rallekralle11/dis_thermometer/README.md

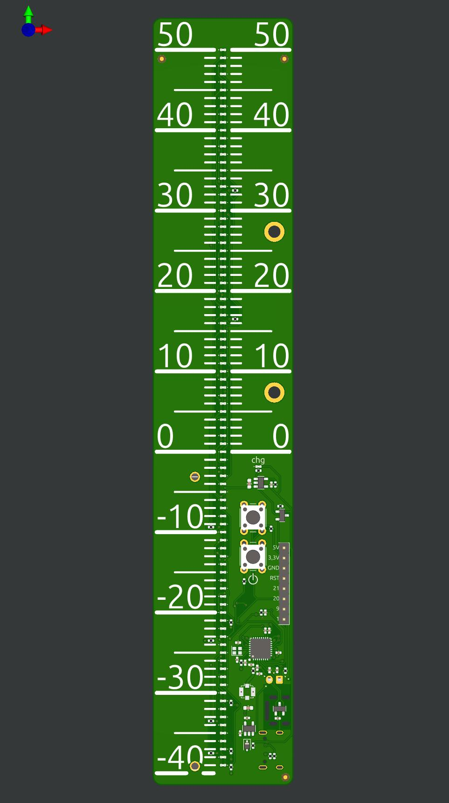
[picture p1: termometer_h.jpg]

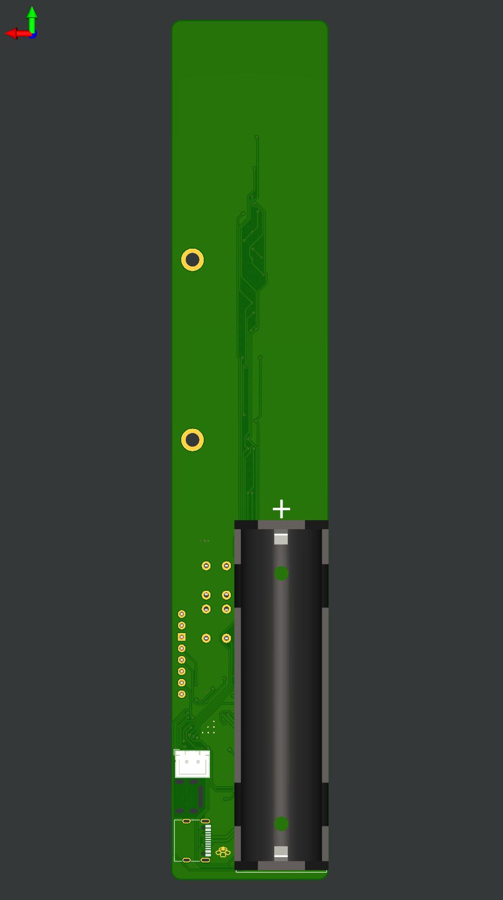
[picture p2: termometer_b.jpg]
