rallekralle11/dis_thermometer/V2_0603/safety.odt

Epi 32U4

safety information

Retain this document

for future reference

Safe use:

- The device should not be operated at above 5,5V DC
- Do not place the powered device on a conductive surface
- Do not expose the device to water
- Do not operate the device at temperatures above 85°C or below -40°C
- Handle the device carefully to prevent mechanical damage and electrostatic discharge
- Double-check the battery polarity before connecting

Warning

Small parts. Do not let

young children access

the device, accessories

or packaging.

Do not dispose of the device

as household waste.

Epi 32U4

säkerhets-information

Spara detta dokument

för framtida referens

Säker användning:

- Produkten bör inte ges över 5,5V DC
- Placera ej den påslagna produkten på ledande ytor
- Håll produkten borta från vatten
- Använd inte produkten I temperaturer över 85°C eller under -40°C
- Hantera produkten varsamt för att undvika mekaniska skador samt statisk urladdning
- Dubbelkolla batteriets polaritet innan det kopplas in

Varning

Små delar. Låt inte mindre barn nå produkten, tillbehören eller förpackningen.

Släng ej produkten

I hushållssopor.

Epi 32U4

Sicherheits-information

Bewahren sie dieses Dokument zum späteren Nachschlagen auf.

Sicherheitshinweise:

- Das Gerät sollte nicht mit mehr als 5,5V DC betrieben werden
- Platzieren Sie das mit Strom versorgte Gerät nicht auf einer leitfähigen Oberfläche
- Setzen Sie das Gerät keinem Wasser aus
- Betreiben Sie das Gerät nicht bei Temperaturen über 85°C oder unter -40°C
- Behandeln Sie das Gerät sorgfältig, verhindern sie mechanische Beschädigungen und elektrostatische Entladung
- Überprüfen Sie noch einmal die Polarität bevor Sie die Batterie anschließen

Warnung

Verschluckbare Kleinteile. Bewahren sie das Gerät, Zubehör und die Verpackung außer Reichweite von Kleinkindern auf.

Entsorgen Sie das Gerät nicht über den Hausmüll.

Epi 32U4

säkerhets-information

Spara detta dokument

för framtida referens

Säker användning:

- Produkten bör inte ges över 5,5V DC
- Placera ej den påslagna produkten på ledande ytor
- Håll produkten borta från vatten
- Använd inte produkten I temperaturer över 85°C eller under -40°C
- Hantera produkten varsamt för att undvika mekaniska skador samt statisk urladdning
- Dubbelkolla batteriets polaritet innan det kopplas in

Varning

Små delar. Låt inte mindre barn nå produkten, tillbehören eller förpackningen.

Släng ej produkten

I hushållssopor.

Epi 32U4

safety information

Retain this document

for future reference

Safe use:

- The device should not be operated at above 5,5V DC
- Do not place the powered device on a conductive surface
- Do not expose the device to water
- Do not operate the device at temperatures above 85°C or below -40°C
- Handle the device carefully to prevent mechanical damage and electrostatic discharge
- Double-check the battery polarity before connecting

Warning

Small parts. Do not let

young children access

the device, accessories

or packaging.

Do not dispose of the device

as household waste.

Epi 32U4

Sicherheits-information

Bewahren sie dieses Dokument zum späteren Nachschlagen auf.

Sicherheitshinweise:

- Das Gerät sollte nicht mit mehr als 5,5V DC betrieben werden
- Platzieren Sie das mit Strom versorgte Gerät nicht auf einer leitfähigen Oberfläche
- Setzen Sie das Gerät keinem Wasser aus
- Betreiben Sie das Gerät nicht bei Temperaturen über 85°C oder unter -40°C
- Behandeln Sie das Gerät sorgfältig, verhindern sie mechanische Beschädigungen und elektrostatische Entladung
- Überprüfen Sie noch einmal die Polarität bevor Sie die Batterie anschließen

Warnung

Verschluckbare Kleinteile. Bewahren sie das Gerät, Zubehör und die Verpackung außer Reichweite von Kleinkindern auf.

Entsorgen Sie das Gerät nicht über den Hausmüll.

Epi 32U4

säkerhets-information

Spara detta dokument

för framtida referens

Säker användning:

- Produkten bör inte ges över 5,5V DC
- Placera ej den påslagna produkten på ledande ytor
- Håll produkten borta från vatten
- Använd inte produkten I temperaturer över 85°C eller under -40°C
- Hantera produkten varsamt för att undvika mekaniska skador samt statisk urladdning
- Dubbelkolla batteriets polaritet innan det kopplas in

Varning

Små delar. Låt inte mindre barn nå produkten, tillbehören eller förpackningen.

Släng ej produkten

I hushållssopor.

Epi 32U4

safety information

Retain this document

for future reference

Safe use:

- The device should not be operated at above 5,5V DC
- Do not place the powered device on a conductive surface
- Do not expose the device to water
- Do not operate the device at temperatures above 85°C or below -40°C
- Handle the device carefully to prevent mechanical damage and electrostatic discharge
- Double-check the battery polarity before connecting

Warning

Small parts. Do not let

young children access

the device, accessories

or packaging.

Do not dispose of the device

as household waste.

Epi 32U4

safety information

Retain this document

for future reference

Safe use:

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

Warning

Small parts. Do not let

young children access

the device, accessories

or packaging.

Do not dispose of the device

as household waste.

Epi 32U4

Sicherheits-information

Bewahren sie dieses Dokument zum späteren Nachschlagen auf.

Sicherheitshinweise:

- Das Gerät sollte nicht mit mehr als 5,5V DC betrieben werden
- Platzieren Sie das mit Strom versorgte Gerät nicht auf einer leitfähigen Oberfläche
- Setzen Sie das Gerät keinem Wasser aus
- Betreiben Sie das Gerät nicht bei Temperaturen über 85°C oder unter -40°C
- Behandeln Sie das Gerät sorgfältig, verhindern sie mechanische Beschädigungen und elektrostatische Entladung
- Überprüfen Sie noch einmal die Polarität bevor Sie die Batterie anschließen

Warnung

Verschluckbare Kleinteile. Bewahren sie das Gerät, Zubehör und die Verpackung außer Reichweite von Kleinkindern auf.

Entsorgen Sie das Gerät nicht über den Hausmüll.

Epi 32U4

Sicherheits-information

Bewahren sie dieses Dokument zum späteren Nachschlagen auf.

Sicherheitshinweise:

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

Warnung

Verschluckbare Kleinteile. Bewahren sie das Gerät, Zubehör und die Verpackung außer Reichweite von Kleinkindern auf.

Entsorgen Sie das Gerät nicht über den Hausmüll.

Epi 32U4

säkerhets-information

Spara detta dokument

för framtida referens

Säker användning:

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

Varning

Små delar. Låt inte mindre barn nå produkten, tillbehören eller förpackningen.

Släng ej produkten

I hushållssopor.
