rallekralle11/dis_thermometer/V2_0603/termometer2.jpg

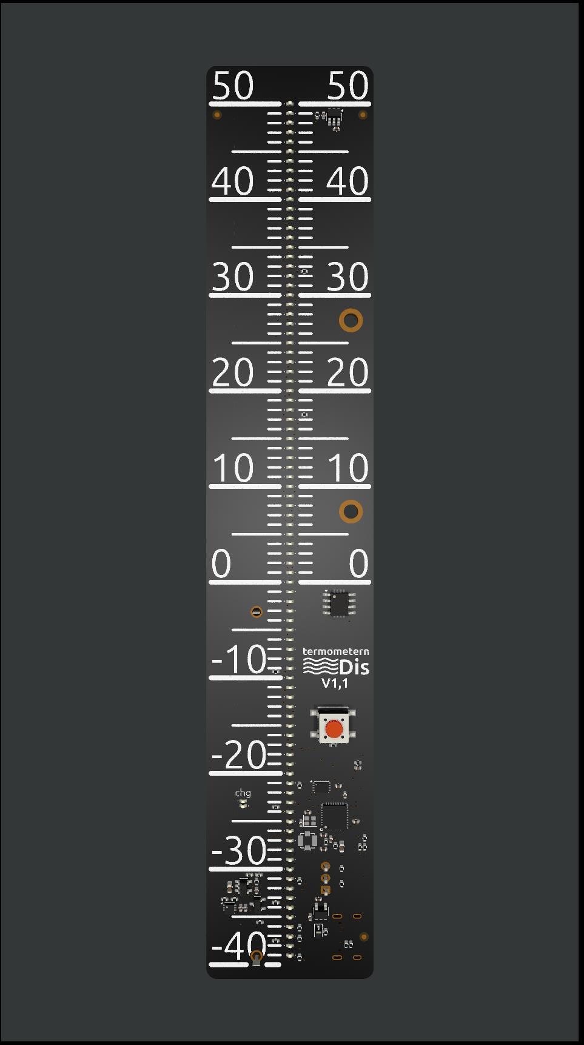
V2_0603/termometer2.jpg
