rallekralle11/dis_thermometer/dis_hållare_lumen.FCStd

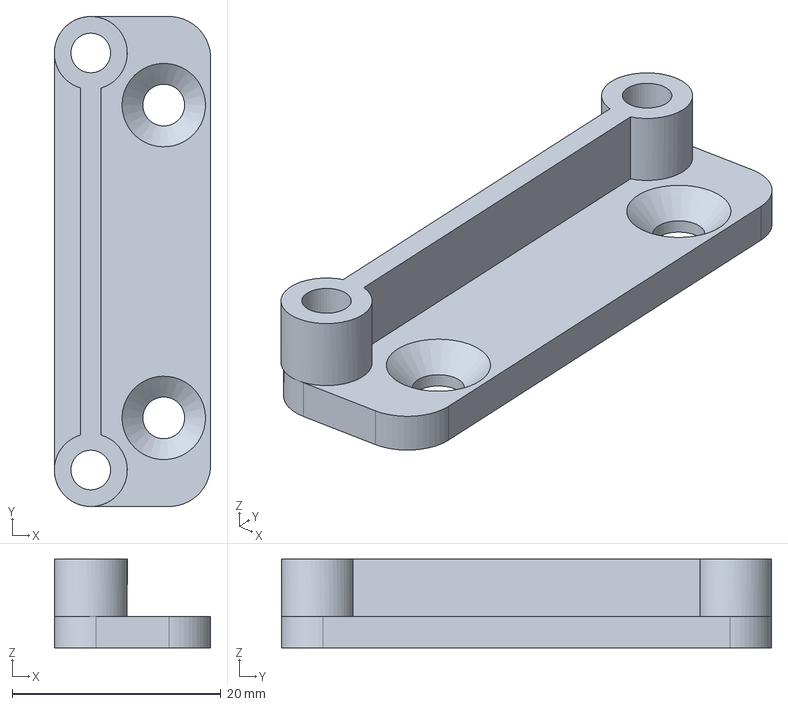
[picture p4: CAD file, 2024-12-08]
dis_hållare_lumen.FCStd
15.0 x 47.0 x 8.50 mm
