rallekralle11/dis_thermometer/V2_0603/jst_gjutform-Body001.obj

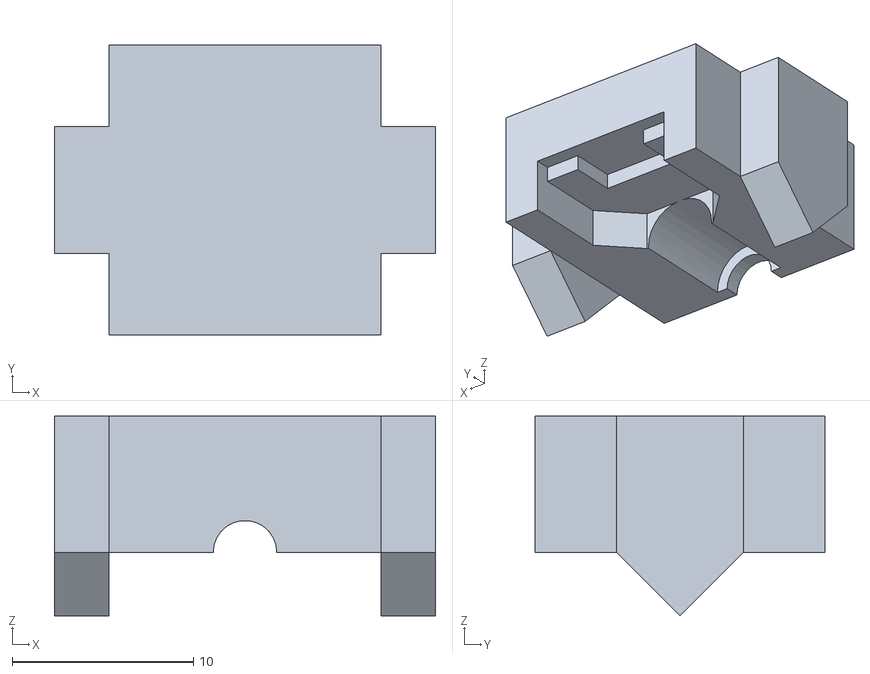
[picture p5: CAD file, 2025-01-25]
V2_0603/jst_gjutform-Body001.obj
21.0 x 16.0 x 11.0
