rallekralle11/dis_thermometer/dis_vägghållare-Body.obj

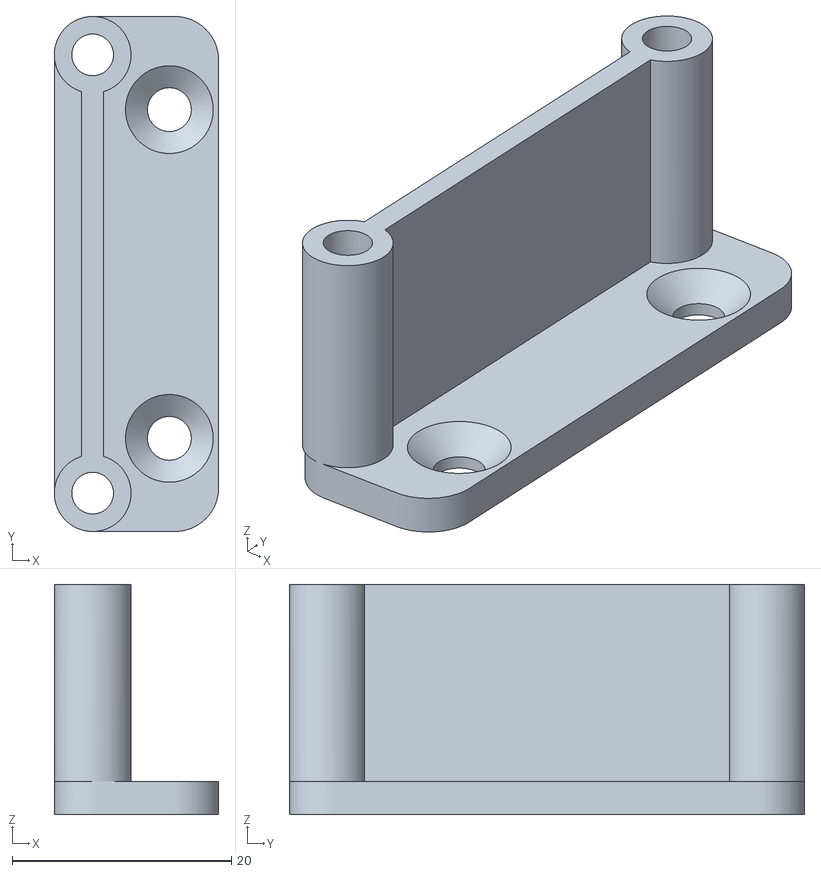
[picture p6: CAD file, 2024-12-08]
dis_vägghållare-Body.obj
15.0 x 47.0 x 21.0
