rallekralle11/dis_thermometer/V2_0603/jst_gjutform-Body.obj

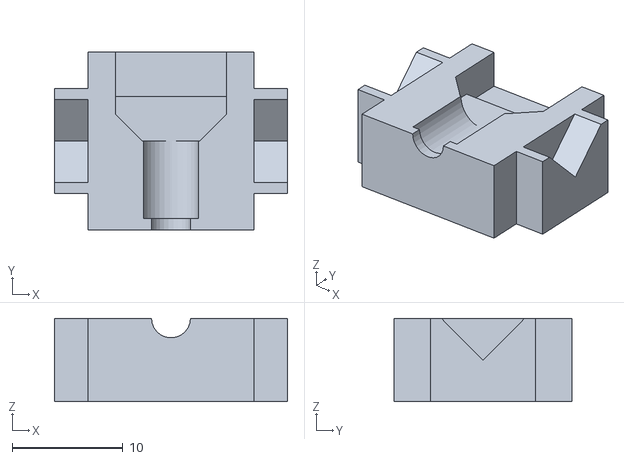
[picture p7: CAD file, 2025-01-25]
V2_0603/jst_gjutform-Body.obj
21.0 x 16.0 x 7.50
