rallekralle11/dis_thermometer/dis_hållare_lumen-Body.obj

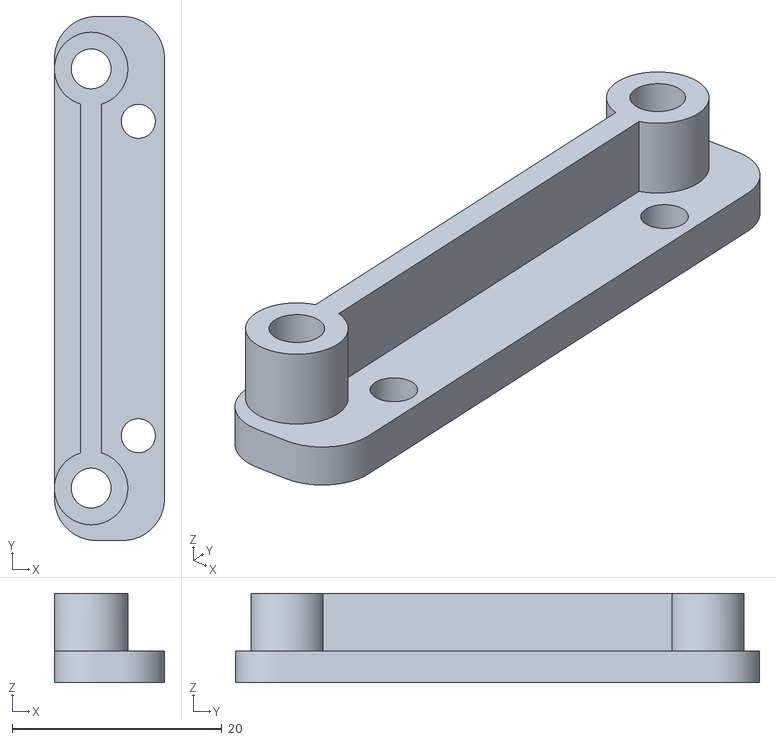
[picture p8: CAD file, 2024-12-06]
dis_hållare_lumen-Body.obj
10.5 x 50.0 x 8.50
