rallekralle11/dis_thermometer/V2_0603/jst_gjutform.FCStd

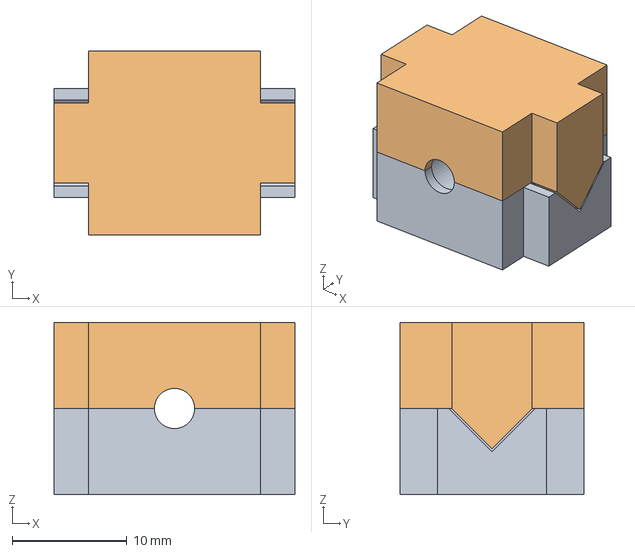
[picture p9: CAD file, 2025-01-25]
V2_0603/jst_gjutform.FCStd
21.0 x 16.0 x 15.0 mm
