rallekralle11/dis_thermometer/manual/10.png

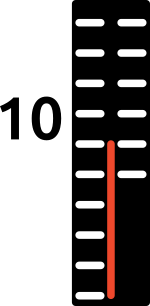
manual/10.png
