rallekralle11/dis_thermometer/manual/20.png

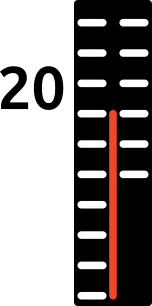
manual/20.png
