rallekralle11/dis_thermometer/manual/40.png

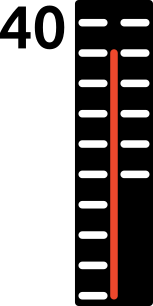
manual/40.png
