rallekralle11/dis_thermometer/manual/50.png

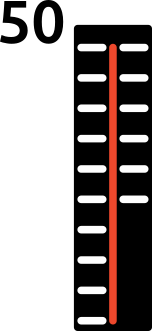
manual/50.png
