rallekralle11/dis_thermometer/väggtermometer.pdf

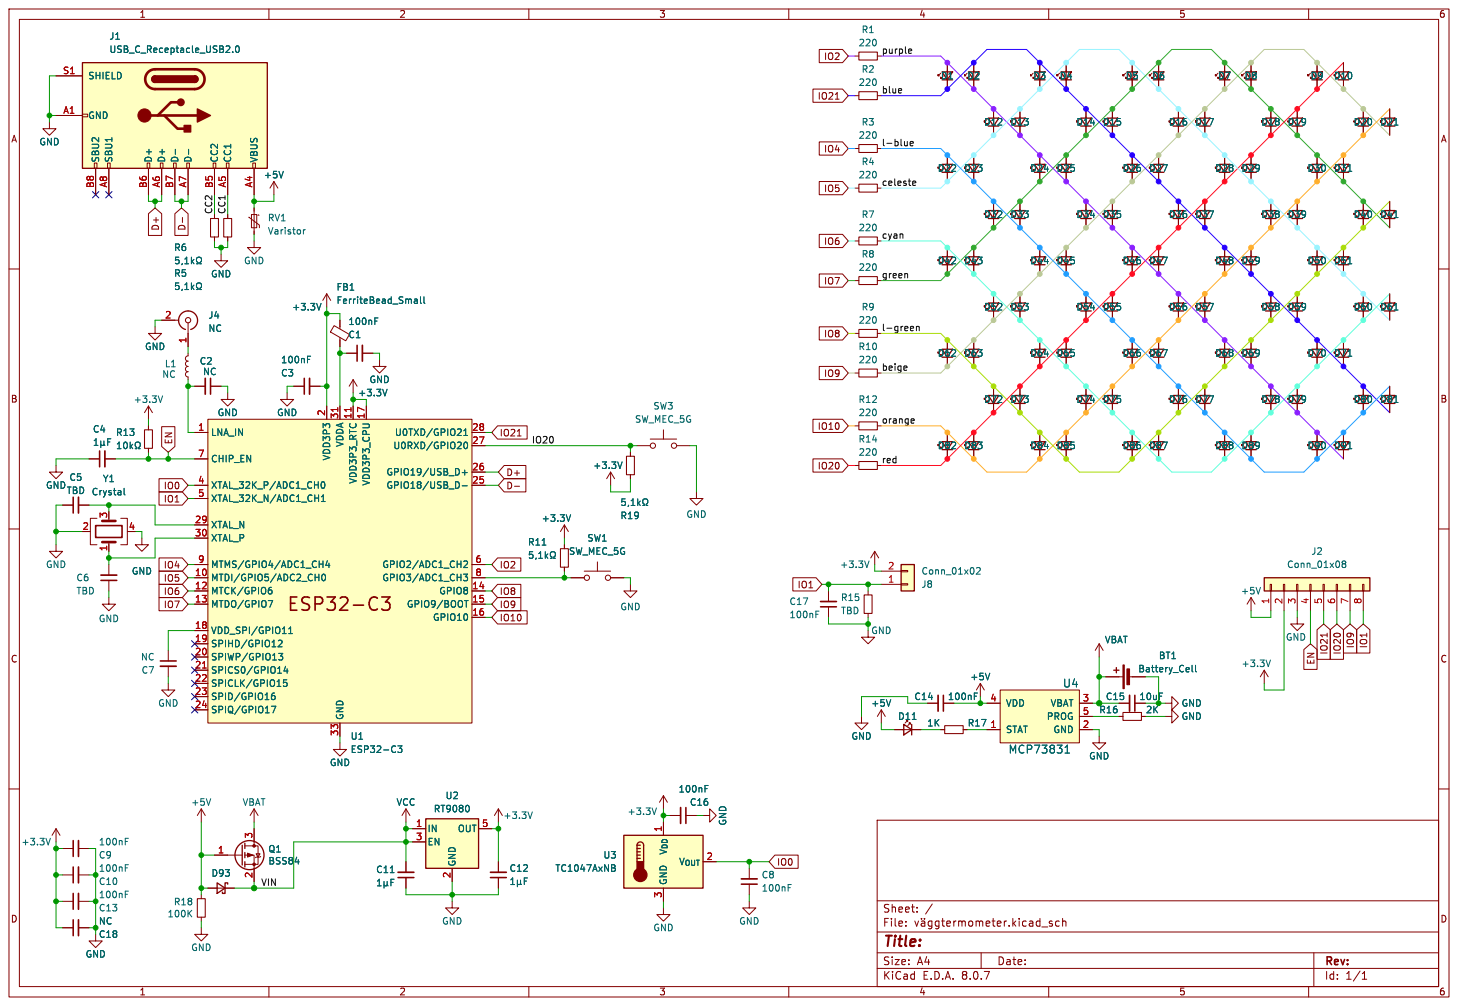
[picture p14: page 1]

2 SPIWP/GPIO13 20 SPICS0/GPIO14 21 SPICLK/GPIO15 22 SPID/GPIO16 23 SPIQ/GPIO17 24 GPIO18/USB_D- 25 GPIO19/USB_D+ 26 U0RXD/GPIO20 27 U0TXD/GPIO21 28 XTAL_N 29 XTAL_P 30 VDDA 31 GND 33 XTAL_32K_P/ADC1_CH0 4 XTAL_32K_N/ADC1_CH1 5 GPIO2/ADC1_CH2 6 CHIP_EN 7 GPIO3/ADC1_CH3 8 MTMS/GPIO4/ADC1_CH4 9 GND GND

2 SPIWP/GPIO13 20 SPICS0/GPIO14 21 SPICLK/GPIO15 22 SPID/GPIO16 23 SPIQ/GPIO17 24 GPIO18/USB_D- 25 GPIO19/USB_D+ 26 U0RXD/GPIO20 27 U0TXD/GPIO21 28 XTAL_N 29 XTAL_P 30 VDDA 31 GND 33 XTAL_32K_P/ADC1_CH0 4 XTAL_32K_N/ADC1_CH1 5 GPIO2/ADC1_CH2 6 CHIP_EN 7 GPIO3/ADC1_CH3 8 MTMS/GPIO4/ADC1_CH4 9 U1ESP32-C3

Id: 1/1 Title: File: þÿväggtermometer.kicad_sch Sheet: /
