rallekralle11/dis_thermometer/manual/dis_manual.pdf

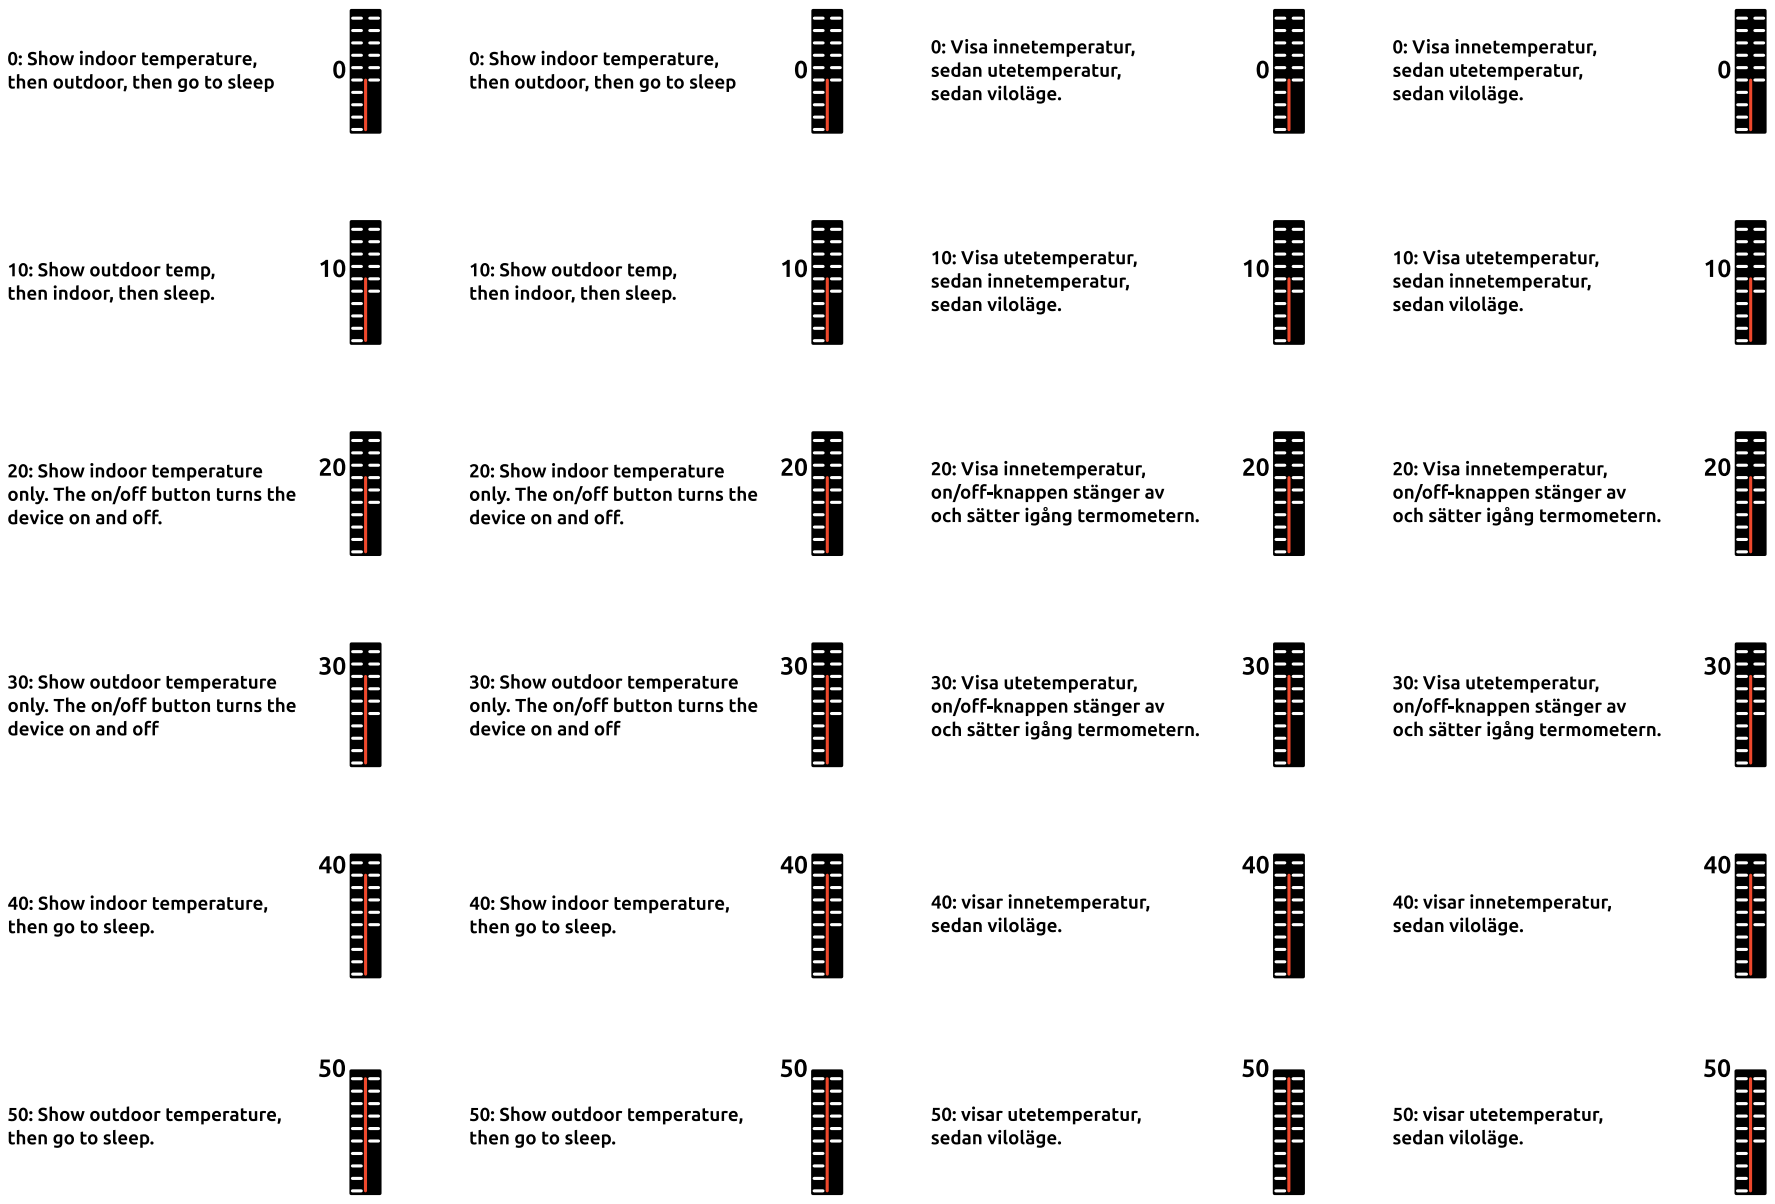
[picture p15: page 1]

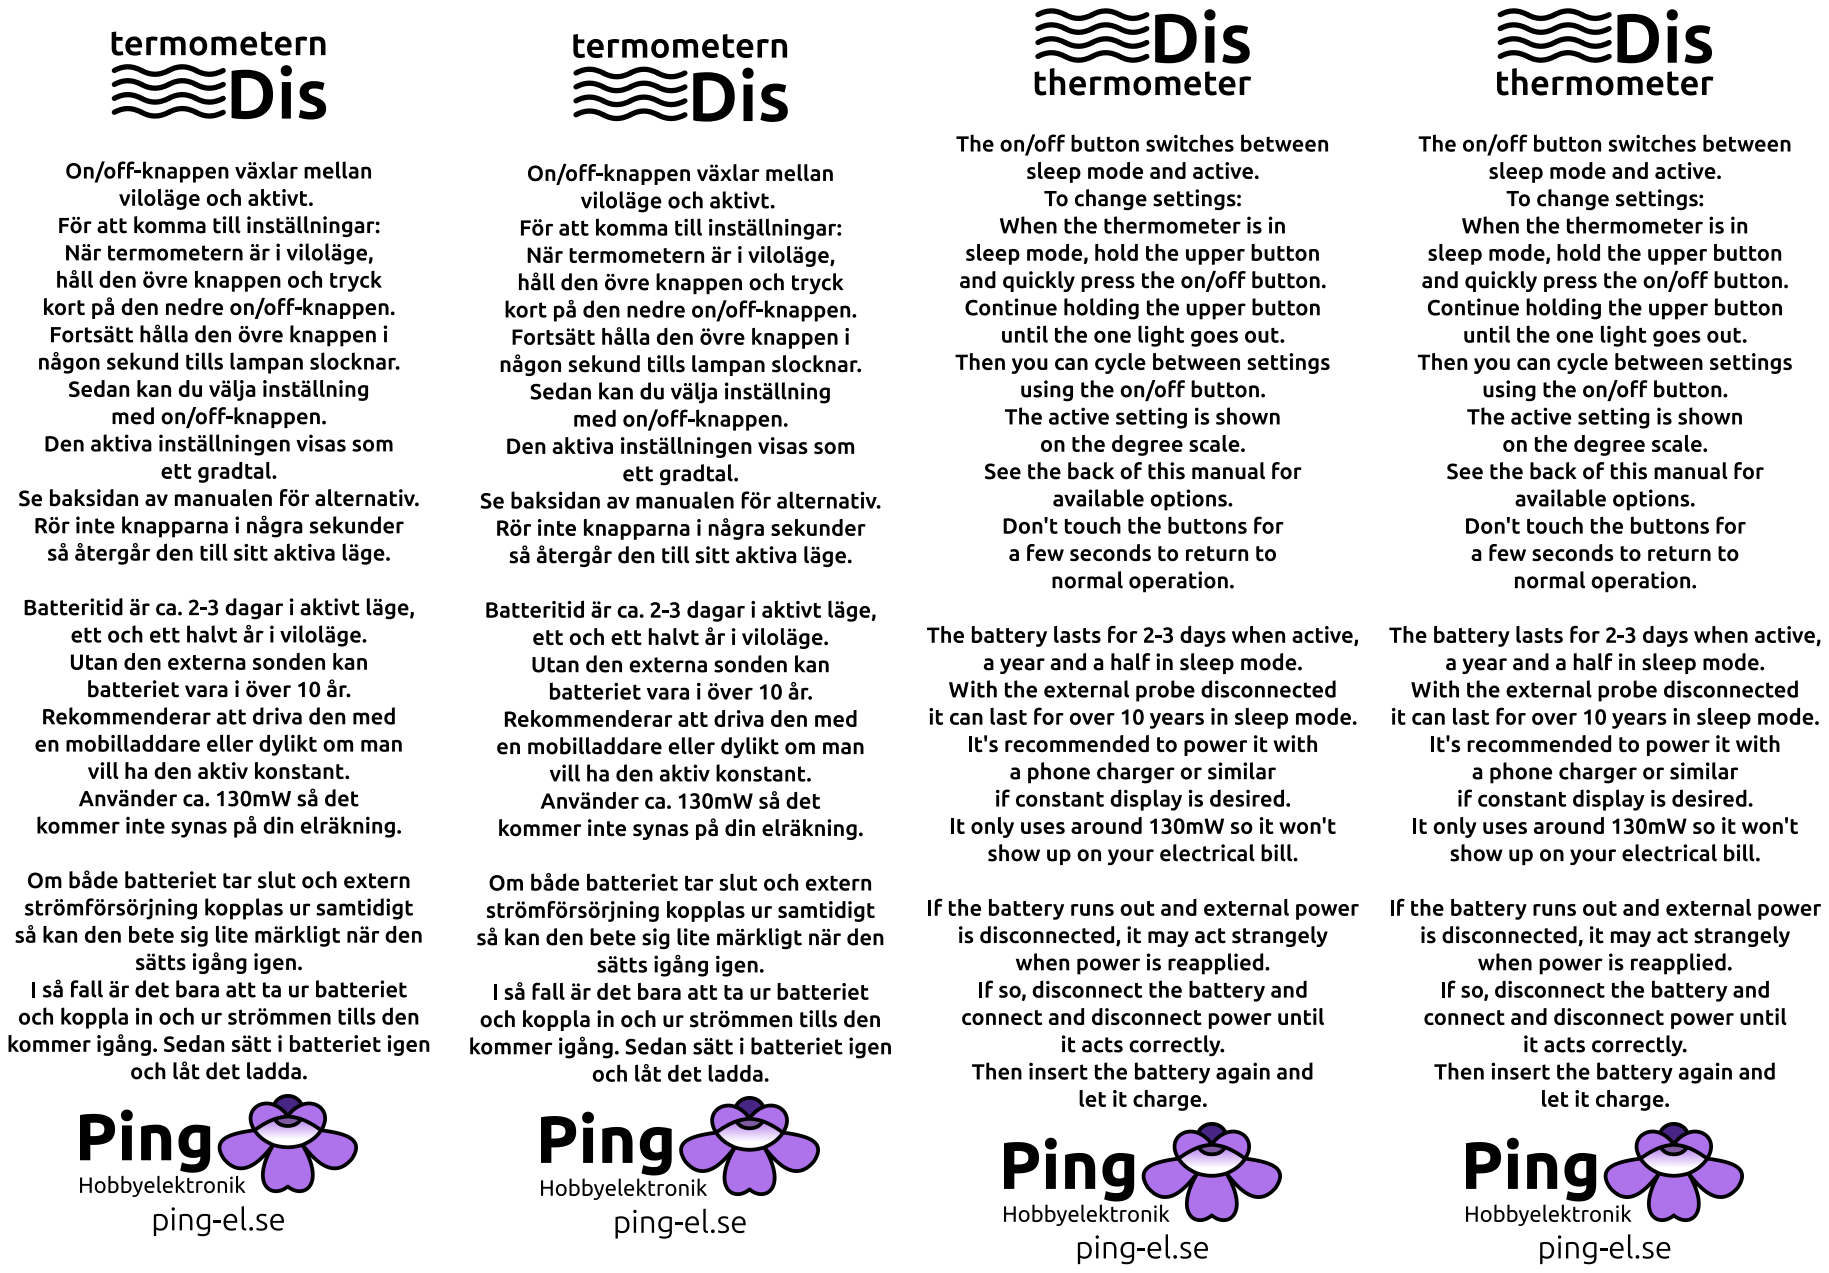
[picture p16: page 2]
