rallekralle11/dis_thermometer/V2_0603/termometer2.kicad_pcb

## KiCad design V2_0603/termometer2.kicad_pcb (2025-01-25)

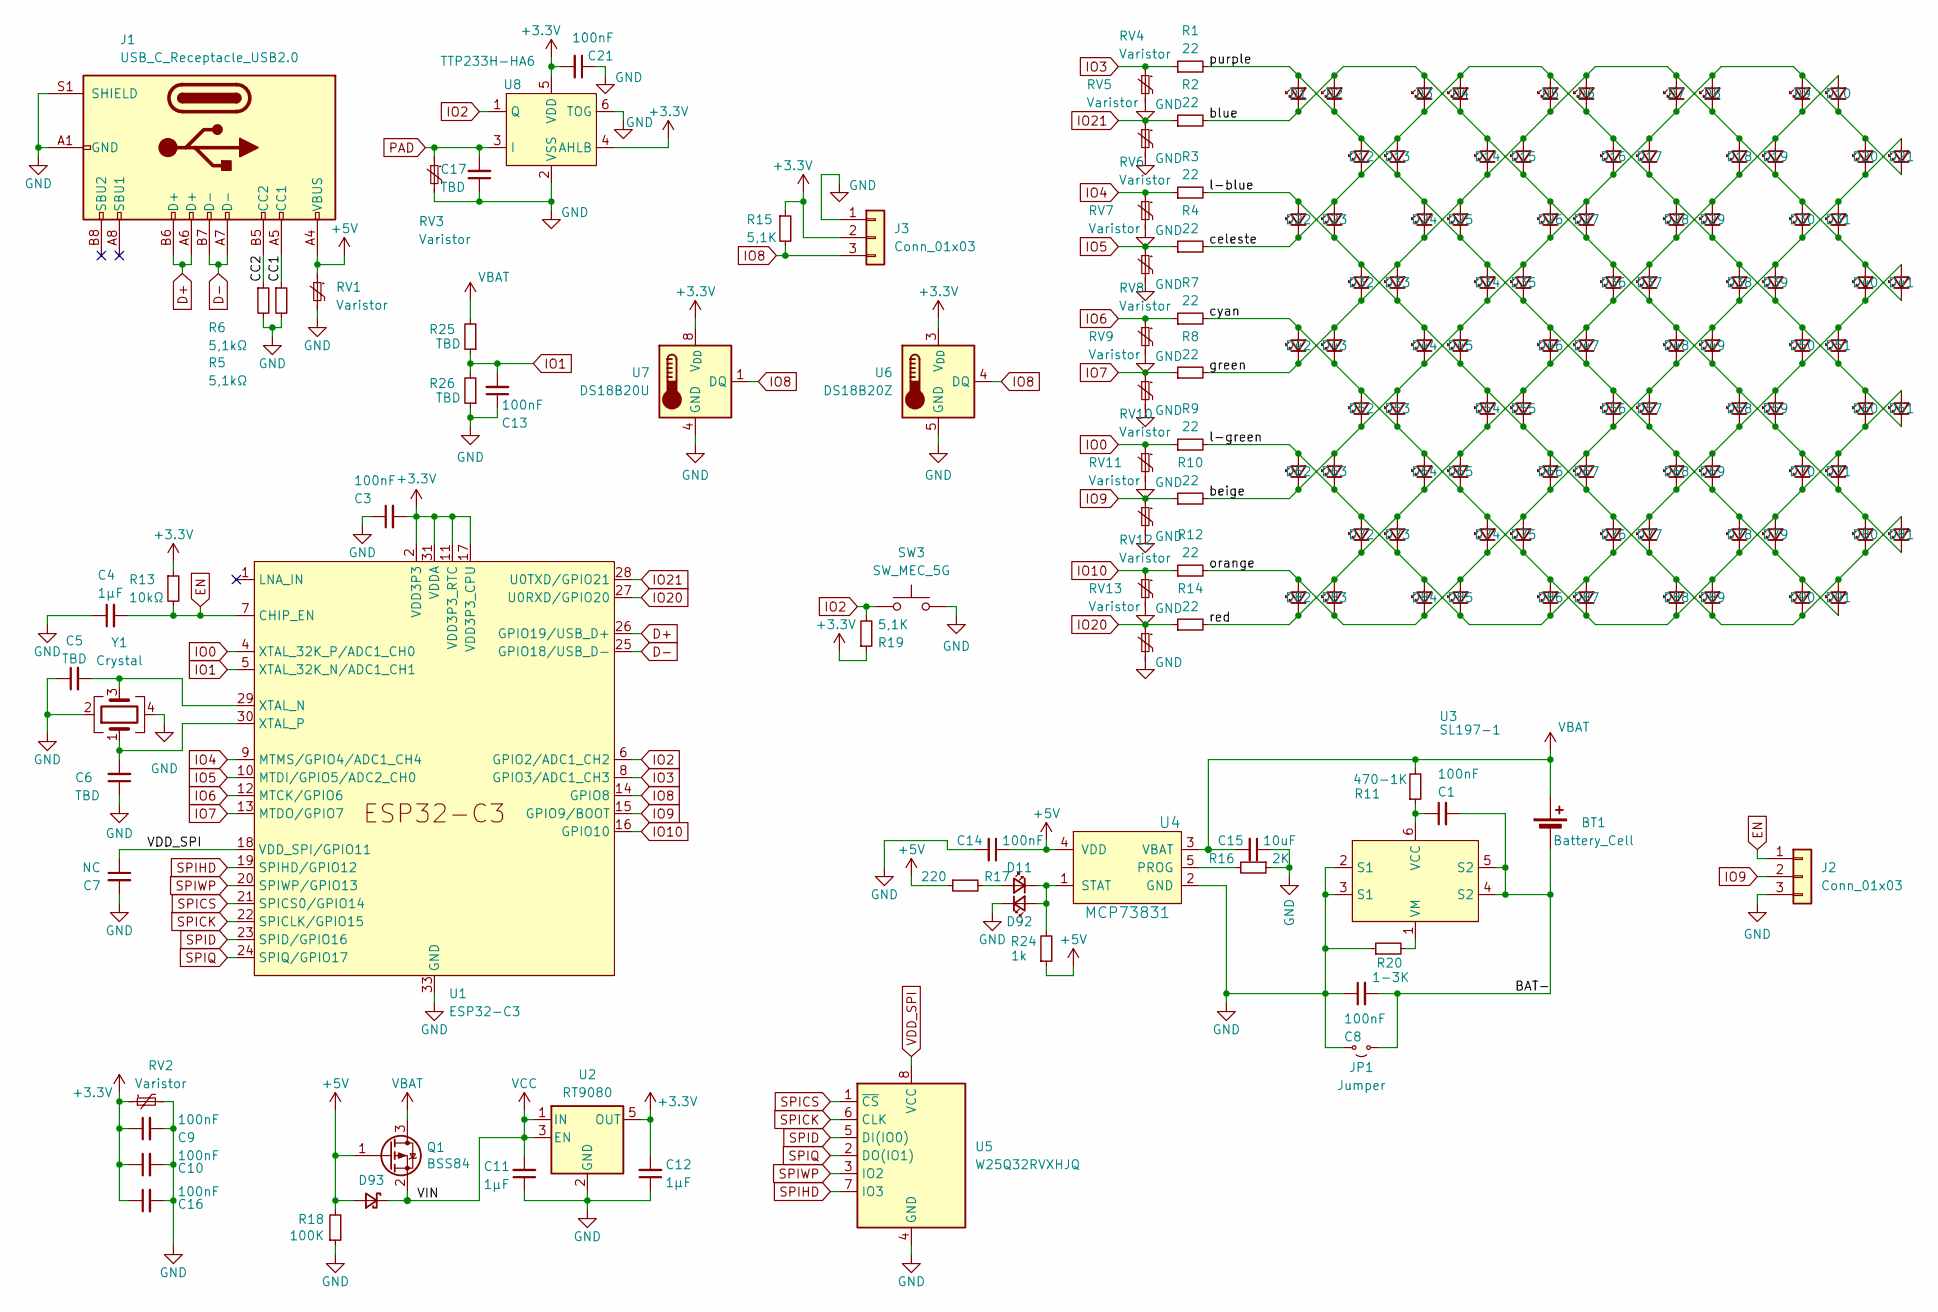
[picture p17: schematic termometer2.kicad_sch]

Parts:
BT1: Battery_Cell; BatteryHolder_MPD_BH-18650-PC2
C1, C3, C8, C9, C10, C13, C14, C16, C21: 100nF; C_0603_1608Metric
C4, C11, C12: 1µF; C_0603_1608Metric
C5, C6, C17: TBD; C_0603_1608Metric
C7: NC; C_0603_1608Metric
C15: 10uF; C_0603_1608Metric
D1, D2, D3, D4, D5, D6, D7, D8, D9, D10, D12, D13, D14, D15, D16, D17, D18, D19, D20, D21, D22, D23, D24, D25, D26, D27, D28, D29, D30, D31, D32, D33, D34, D35, D36, D37, D38, D39, D40, D41, D42, D43, D44, D45, D46, D47, D48, D49, D50, D51, D52, D53, D54, D55, D56, D57, D58, D59, D60, D61, D62, D63, D64, D65, D66, D67, D68, D69, D70, D71, D72, D73, D74, D75, D76, D77, D78, D79, D80, D81, D82, D83, D84, D85, D86, D87, D88, D89, D90, D91: LED_0603_1608Metric
D11, D92: LED_CHR; LED_0603_1608Metric
D93: D_Schottky_Small; D_SOD-323; LCSC C114023
J1: USB_C_Receptacle_USB2.0; USB_C_Receptacle_G-Switch_GT-USB-7010ASV
J2: Conn_01x03; PinHeader_1x03_P2.54mm_Vertical
J3: Conn_01x03; JST_XH_B3B-XH-A_1x03_P2.50mm_Vertical
JP1: Jumper; SolderJumper-2_P1.3mm_Open_RoundedPad1.0x1.5mm
Q1: BSS84; SOT-23; LCSC C85202
R1, R2, R3, R4, R7, R8, R9, R10, R12, R14: 22; R_0603_1608Metric
R5, R6: 5,1kΩ; R_0603_1608Metric
R11: 470-1K; R_0603_1608Metric
R13: 10kΩ; R_0603_1608Metric
R15, R19: 5,1K; R_0603_1608Metric
R16: 2K; R_0603_1608Metric
R17: 220; R_0603_1608Metric
R18: 100K; R_0603_1608Metric
R20: 1-3K; R_0603_1608Metric
R24: 1k; R_0603_1608Metric
R25, R26: TBD; R_0603_1608Metric
RV1, RV2, RV3, RV4, RV5, RV6, RV7, RV8, RV9, RV10, RV11, RV12, RV13: Varistor; R_0603_1608Metric
SW3: SW_MEC_5G; SW_SPST_B3S-1000
U1: ESP32-C3; QFN-32-1EP_5x5mm_P0.5mm_EP3.45x3.45mm
U2: RT9080; SOT-23-5
U3: SL197-1; DFN-6-1EP_2x2mm_P0.5mm_EP0.6x1.37mm
U4: MCP73831; SOT-23-5; LCSC C14879
U5: W25Q32RVXHJQ; Winbond_USON-8-1EP_3x2mm_P0.5mm_EP0.2x1.6mm
U6: DS18B20Z; SOIC-8_3.9x4.9mm_P1.27mm
U7: DS18B20U; MSOP-8_3x3mm_P0.65mm
U8: TTP233H-HA6; SOT-23-6
Y1: Crystal; Crystal_SMD_2016-4Pin_2.0x1.6mm

Connections:
+3.3V: C3.2, C9.1, C10.1, C12.2, C16.1, C21.2, J3.2, R13.1, R15.1, R19.1, RV2.1, U1.2 (VDD3P3), U1.3 (VDD3P3), U1.11 (VDD3P3_RTC), U1.17 (VDD3P3_CPU), U1.31 (VDDA), U1.32 (VDDA), U2.5 (OUT), U6.3 (V_{DD}), U7.8 (V_{DD}), U8.4 (AHLB), U8.5 (VDD)
+5V: C14.1, D93.2 (A), J1.A4 (VBUS), J1.A9 (VBUS), J1.B4 (VBUS), J1.B9 (VBUS), Q1.1 (G), R17.1, R18.2, R24.1, RV1.1, U4.4 (VDD)
/BAT-: BT1.2 (-), C1.2, C8.2, JP1.1 (A), U3.4 (S2), U3.5 (S2)
/CC1: J1.A5 (CC1), R6.1
/CC2: J1.B5 (CC2), R5.1
/beige: D7.1 (K), D8.2 (A), D9.2 (A), D10.1 (K), D16.1 (K), D17.2 (A), D20.2 (A), D21.1 (K), D26.1 (K), D27.2 (A), D34.1 (K), D35.2 (A), D44.1 (K), D45.2 (A), D52.1 (K), D53.2 (A), D62.1 (K), D63.2 (A), R10.2
/blue: D1.1 (K), D2.2 (A), D3.2 (A), D4.1 (K), D14.2 (A), D15.1 (K), D26.2 (A), D27.1 (K), D36.2 (A), D37.1 (K), D48.2 (A), D49.1 (K), D58.2 (A), D59.1 (K), D70.2 (A), D71.1 (K), D80.2 (A), D81.1 (K), R2.2
/celeste: D3.1 (K), D4.2 (A), D5.2 (A), D6.1 (K), D12.1 (K), D13.2 (A), D16.2 (A), D17.1 (K), D22.1 (K), D23.2 (A), D28.2 (A), D29.1 (K), D38.2 (A), D39.1 (K), D50.2 (A), D51.1 (K), D60.2 (A), D61.1 (K), R4.2
/cyan: D42.2 (A), D43.1 (K), D52.2 (A), D53.1 (K), D60.1 (K), D61.2 (A), D64.2 (A), D65.1 (K), D70.1 (K), D71.2 (A), D74.2 (A), D75.1 (K), D78.1 (K), D79.2 (A), D86.2 (A), D87.1 (K), D88.1 (K), D89.2 (A), R7.2
/green: D5.1 (K), D6.2 (A), D7.2 (A), D8.1 (K), D14.1 (K), D15.2 (A), D18.2 (A), D19.1 (K), D24.1 (K), D25.2 (A), D30.2 (A), D31.1 (K), D32.1 (K), D33.2 (A), D40.2 (A), D41.1 (K), D42.1 (K), D43.2 (A), R8.2
/l-blue: D22.2 (A), D23.1 (K), D32.2 (A), D33.1 (K), D44.2 (A), D45.1 (K), D54.2 (A), D55.1 (K), D66.2 (A), D67.1 (K), D76.2 (A), D77.1 (K), D80.1 (K), D81.2 (A), D88.2 (A), D89.1 (K), D90.1 (K), D91.2 (A), R3.2
/l-green: D40.1 (K), D41.2 (A), D50.1 (K), D51.2 (A), D58.1 (K), D59.2 (A), D62.2 (A), D63.1 (K), D68.1 (K), D69.2 (A), D72.2 (A), D73.1 (K), D76.1 (K), D77.2 (A), D84.2 (A), D85.1 (K), D86.1 (K), D87.2 (A), R9.2
/orange: D20.1 (K), D21.2 (A), D30.1 (K), D31.2 (A), D38.1 (K), D39.2 (A), D48.1 (K), D49.2 (A), D56.1 (K), D57.2 (A), D66.1 (K), D67.2 (A), D74.1 (K), D75.2 (A), D82.2 (A), D83.1 (K), D84.1 (K), D85.2 (A), R12.2
/purple: D1.2 (A), D2.1 (K), D12.2 (A), D13.1 (K), D24.2 (A), D25.1 (K), D34.2 (A), D35.1 (K), D46.2 (A), D47.1 (K), D56.2 (A), D57.1 (K), D68.2 (A), D69.1 (K), D78.2 (A), D79.1 (K), D90.2 (A), D91.1 (K), R1.2
/red: D9.1 (K), D10.2 (A), D18.1 (K), D19.2 (A), D28.1 (K), D29.2 (A), D36.1 (K), D37.2 (A), D46.1 (K), D47.2 (A), D54.1 (K), D55.2 (A), D64.1 (K), D65.2 (A), D72.1 (K), D73.2 (A), D82.1 (K), D83.2 (A), R14.2
D+: J1.A6 (D+), J1.B6 (D+), U1.26 (GPIO19/USB_D+)
D-: J1.A7 (D-), J1.B7 (D-), U1.25 (GPIO18/USB_D-)
EN: C4.2, J2.1, R13.2, U1.7 (CHIP_EN)
GND: C3.1, C4.1, C5.1, C6.1, C7.2, C8.1, C9.2, C10.2, C11.1, C12.1, C13.1, C14.2, C15.1, C16.2, C17.1, C21.1, D92.1 (K), J1.A1 (GND), J1.A12 (GND), J1.B1 (GND), J1.B12 (GND), J1.S1 (SHIELD), J2.3, J3.1, JP1.2 (B), R5.2, R6.2, R16.1, R18.1, R20.1, R26.1, RV1.2, RV2.2, RV3.2, RV4.2, RV5.2, RV6.2, RV7.2, RV8.2, RV9.2, RV10.2, RV11.2, RV12.2, RV13.2, SW3.3 (B), SW3.4 (B), U1.33 (GND), U2.2 (GND), U3.2 (S1), U3.3 (S1), U4.2 (GND), U5.4 (GND), U6.5 (GND), U7.4 (GND), U8.2 (VSS), U8.6 (TOG), Y1.2, Y1.4
IO0: R9.1, RV10.1, U1.4 (XTAL_32K_P/ADC1_CH0)
IO1: C13.2, R25.1, R26.2, U1.5 (XTAL_32K_N/ADC1_CH1)
IO2: R19.2, SW3.1 (A), SW3.2 (A), U1.6 (GPIO2/ADC1_CH2), U8.1 (Q)
IO3: R1.1, RV4.1, U1.8 (GPIO3/ADC1_CH3)
IO4: R3.1, RV6.1, U1.9 (MTMS/GPIO4/ADC1_CH4)
IO5: R4.1, RV7.1, U1.10 (MTDI/GPIO5/ADC2_CH0)
IO6: R7.1, RV8.1, U1.12 (MTCK/GPIO6)
IO7: R8.1, RV9.1, U1.13 (MTDO/GPIO7)
IO8: J3.3, R15.2, U1.14 (GPIO8), U6.4 (DQ), U7.1 (DQ)
IO9: J2.2, R10.1, RV11.1, U1.15 (GPIO9/BOOT)
IO10: R12.1, RV12.1, U1.16 (GPIO10)
IO20: R14.1, RV13.1, U1.27 (U0RXD/GPIO20)
IO21: R2.1, RV5.1, U1.28 (U0TXD/GPIO21)
unnamed: D11.2 (A), R17.2
unnamed: D11.1 (K), D92.2 (A), R24.2, U4.1 (STAT)
unnamed: C5.2, U1.29 (XTAL_N), Y1.3
unnamed: C6.2, U1.30 (XTAL_P), Y1.1
unnamed: C1.1, R11.1, U3.6 (VCC)
unnamed: R20.2, U3.1 (VM)
unnamed: R16.2, U4.5 (PROG)
PAD: C17.2, RV3.1, U8.3 (I)
SPICK: U1.22 (SPICLK/GPIO15), U5.6 (CLK)
SPICS: U1.21 (SPICS0/GPIO14), U5.1 (~CS)
SPID: U1.23 (SPID/GPIO16), U5.5 (DI(IO0))
SPIHD: U1.19 (SPIHD/GPIO12), U5.7 (IO3)
SPIQ: U1.24 (SPIQ/GPIO17), U5.2 (DO(IO1))
SPIWP: U1.20 (SPIWP/GPIO13), U5.3 (IO2)
VBAT: BT1.1 (+), C15.2, Q1.3 (D), R11.2, R25.2, U4.3 (VBAT)
VCC: C11.2, D93.1 (K), Q1.2 (S), U2.1 (IN), U2.3 (EN)
VDD_SPI: C7.1, U1.18 (VDD_SPI/GPIO11), U5.8 (VCC)

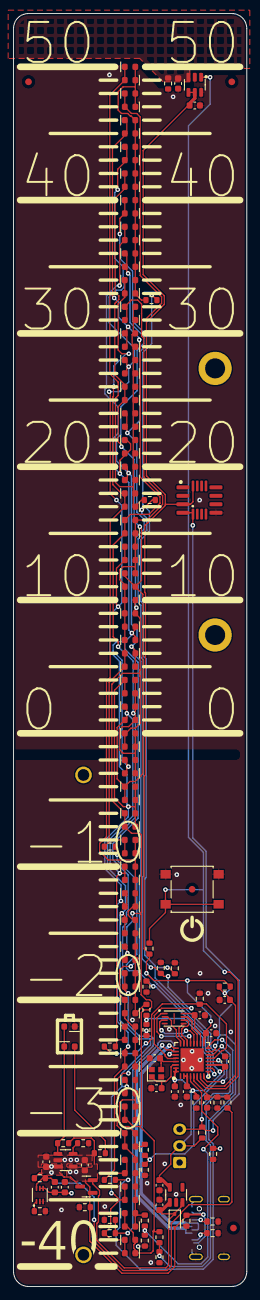
[picture p18: board termometer2.kicad_pcb from above]

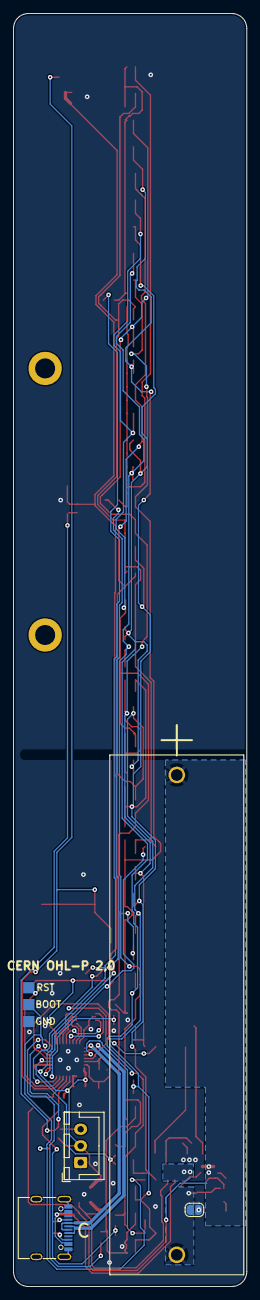
[picture p19: board termometer2.kicad_pcb from below]

Board: 2 copper layers, 35.0 x 191.0 mm, 168 parts (5 on the bottom side), 49 nets.

Other parts of the board:
FID1, FID2, FID3, FID4: Fiducial_1mm_Mask2mm
REF1, REF2: TestPoint_Loop_D3.80mm_Drill2.0mm
