rallekralle11/dis_thermometer/(commit log)

2024-09-18 pictures etc
    [väggtermometer-B_Cu.gbr, väggtermometer-B_Mask.gbr, väggtermometer-B_Paste.gbr, väggtermometer-B_Silkscreen.gbr, väggtermometer-Edge_Cuts.gbr, väggtermometer-F_Cu.gbr, väggtermometer-F_Mask.gbr, väggtermometer-F_Paste.gbr]
2024-10-07 code functional and some changes
    [väggtermometer.kicad_pcb]
2024-10-07 removed leftovers
    [väggtermometer.kicad_pcb]
2024-12-08 info and stuff
    [dis_hållare_lumen.FCStd, dis_vägghållare-Body.obj, väggtermometer.kicad_pcb, väggtermometer.kicad_sch]
2024-12-11 started on version 2 and included libraries with sketch
    [termometer2.kicad_pcb, termometer2.kicad_sch]
