rallekralle11/dis_thermometer/(notices)

Notices in the files:
väggtermometer.kicad_pcb:
CERN-OHL-P 2,0
